mashrursaademad/sap-1-computer-proteus/results/figures/pcb-layouts/instruction_register_pcb.png

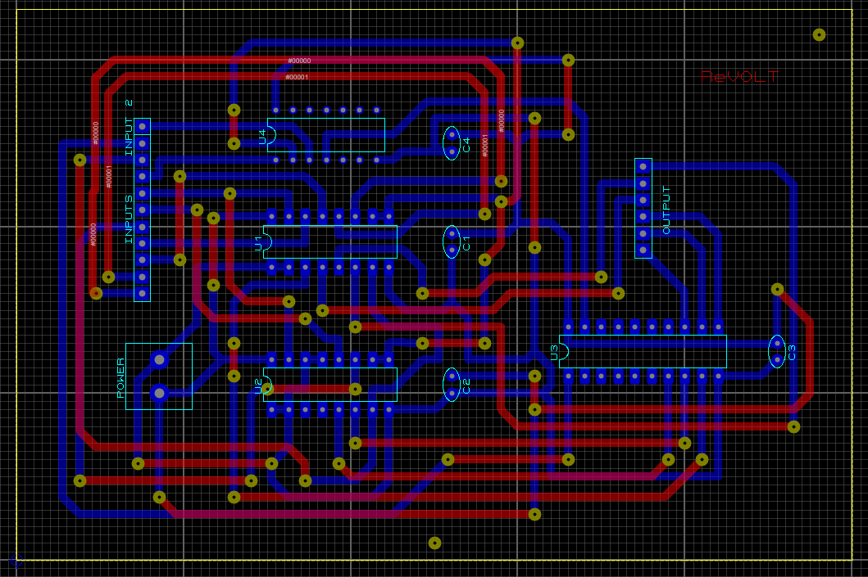
results/figures/pcb-layouts/instruction_register_pcb.png
