mashrursaademad/sap-1-computer-proteus/results/figures/pcb-layouts/address_selector_pcb.png

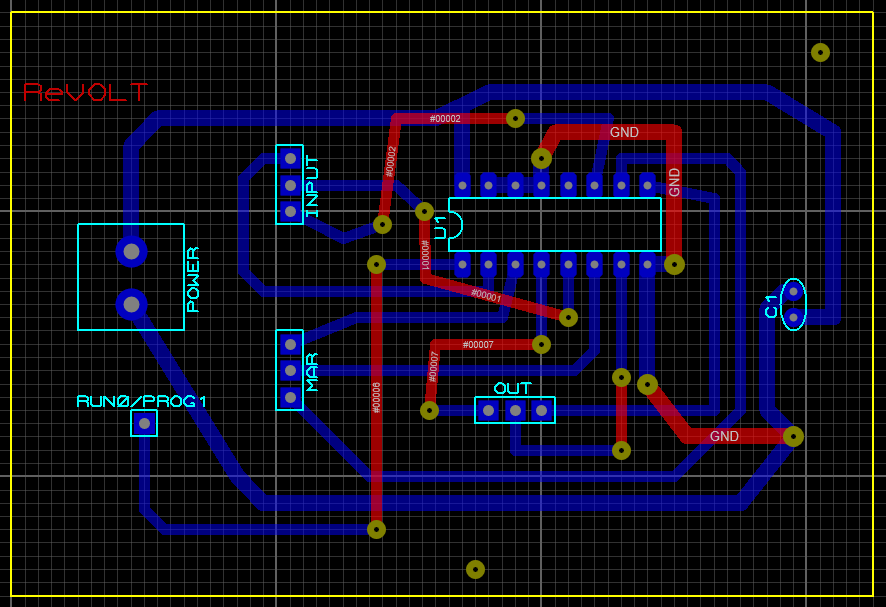
results/figures/pcb-layouts/address_selector_pcb.png
