mashrursaademad/sap-1-computer-proteus/results/figures/pcb-layouts/b_register_pcb.png

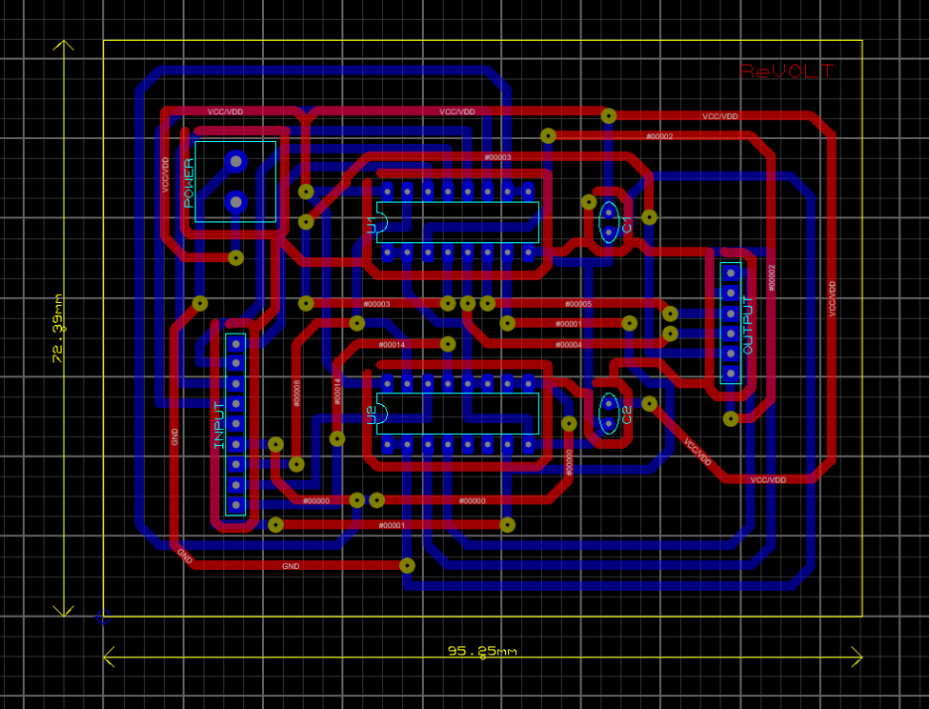
results/figures/pcb-layouts/b_register_pcb.png
