mashrursaademad/sap-1-computer-proteus/results/figures/pcb-layouts/clock_pcb.png

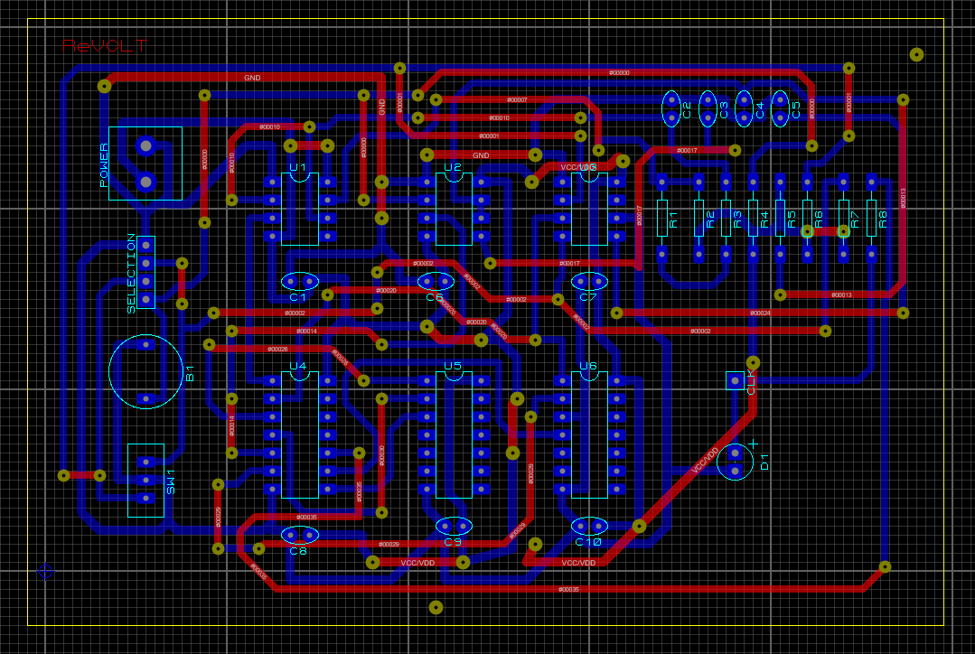
results/figures/pcb-layouts/clock_pcb.png
