mashrursaademad/sap-1-computer-proteus/results/figures/pcb-layouts/control_sequencer_pcb.png

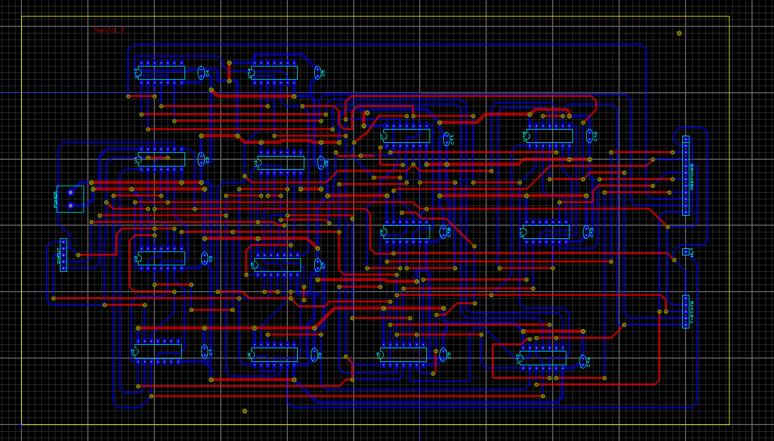
results/figures/pcb-layouts/control_sequencer_pcb.png
