mashrursaademad/sap-1-computer-proteus/results/figures/pcb-layouts/input_unit_pcb.png

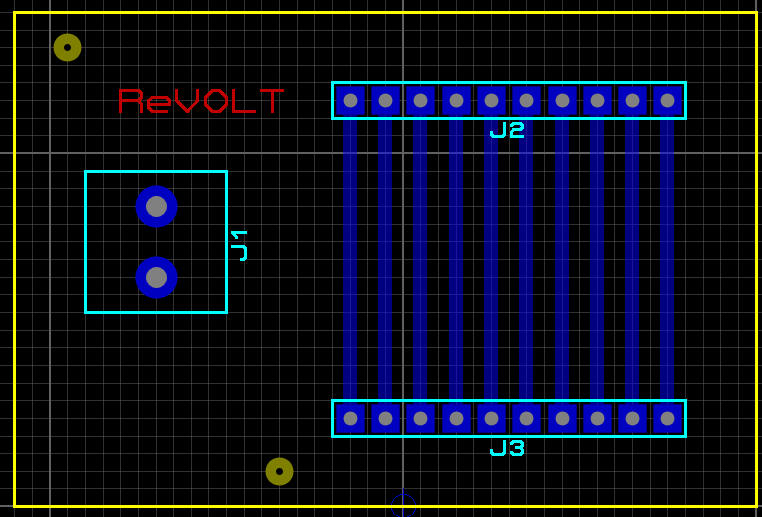
results/figures/pcb-layouts/input_unit_pcb.png
