mashrursaademad/sap-1-computer-proteus/results/figures/pcb-layouts/mar_pcb.png

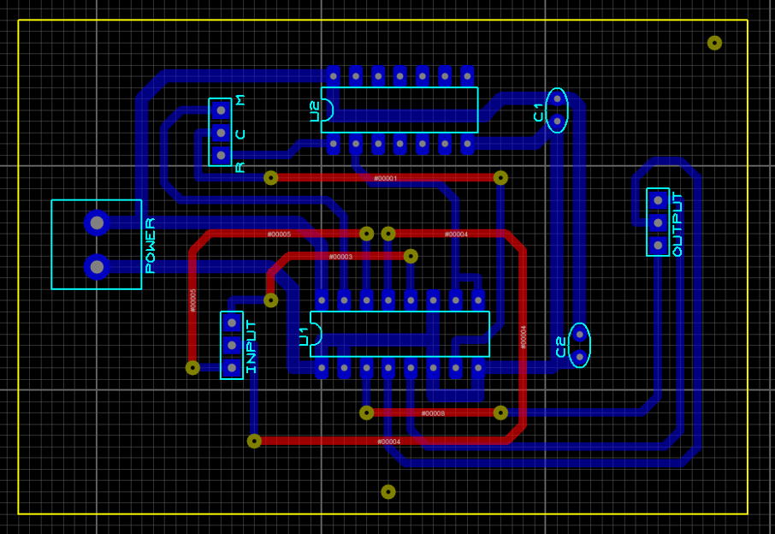
results/figures/pcb-layouts/mar_pcb.png
