mashrursaademad/sap-1-computer-proteus/results/figures/pcb-layouts/output_register_pcb.png

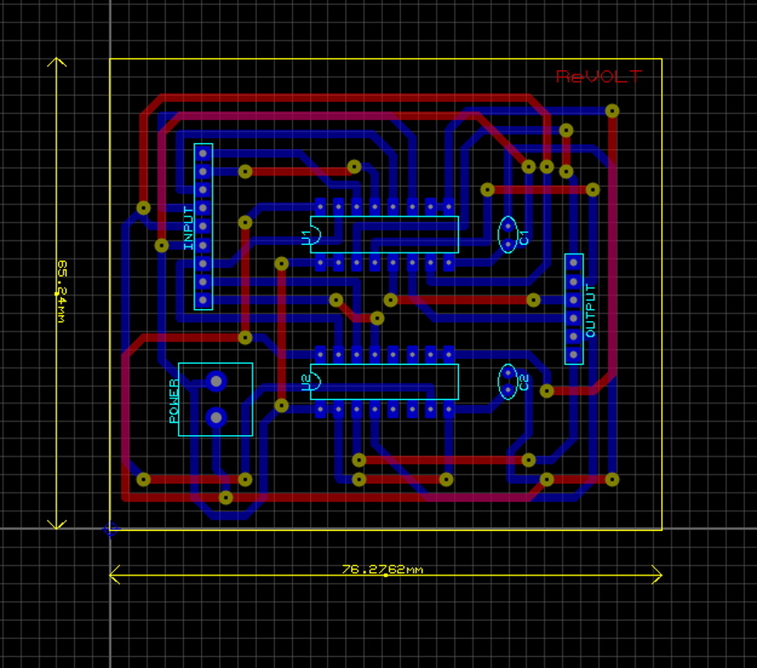
results/figures/pcb-layouts/output_register_pcb.png
