mashrursaademad/sap-1-computer-proteus/results/figures/pcb-layouts/program_counter_pcb.png

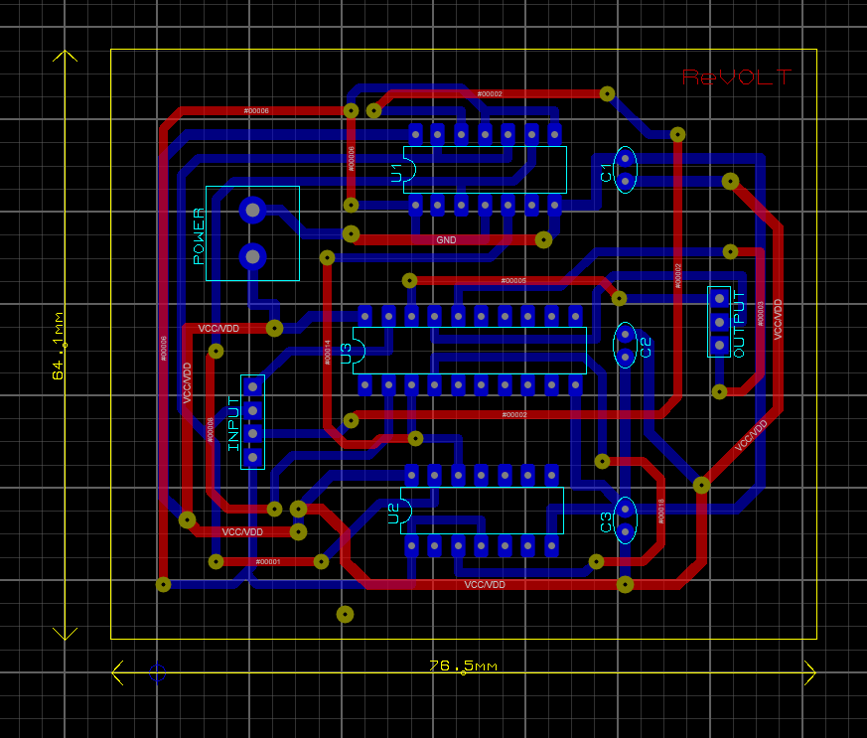
results/figures/pcb-layouts/program_counter_pcb.png
