mashrursaademad/sap-1-computer-proteus/(list of files, drawings)

Other design files:
proteus/final-system/SAP_1_Computer_Team_ReVOLT.pdsprj
proteus/modules/Accumulator.pdsprj
proteus/modules/Address_Selector.pdsprj
proteus/modules/ALU.pdsprj
proteus/modules/B_Register.pdsprj
proteus/modules/Clock.pdsprj
proteus/modules/Control_Sequencer.pdsprj
proteus/modules/Input_Unit.pdsprj
proteus/modules/Instruction_Register.pdsprj
proteus/modules/MAR.pdsprj
proteus/modules/Output_Register.pdsprj
proteus/modules/Program_Counter.pdsprj
proteus/modules/RAM.pdsprj
